sweentj/SproutSenseProto/SproutSync-Pin-Mapping-Petal-Ecosystem.xlsx

Sheet: Apollo3 Pin Functions
 |  |  |  |  |  |  |  |  |  | Pad Function Select Number (PADnFNCSEL) |  |  |  |  |  |  |  |  |  | NCE Chp Select Mux |  |  |  | CT CTimer Input Selection |  | CT - CTimer Output Selection
NM180100 Pin | Apollo3 BGA PIN | Apollo3 Pad | Design Notes | Schematic Net Name | Apollo3 Function Used | NCE/CT FNC Used | Pad FNCSEL # | NCE/CT Sel # | Pad | 0 | 1 | 2 | 3 | 4 | 5 | 6 | 7 | CSP PKG | Max Drive Strength | 0 | 1 | 2 | 3 | 0 | 1 | 2 | 3 | 4 | 5 | 6 | 7
C4 | H4 | PAD00 |  |  | GPIO00 |  | 3 |  | 0 | SLSCL | SLSCK | CLKOUT | GPIO00 | - | MSPI4 | - | NCE0 | X | 12mA | M3.2 | M4.2 | M5.2 | M1.3 |  |  |  |  |  |  |  |  | Function Highlight Control
C5 | G4 | PAD01 |  | WRT_ENA | GPIO01 |  | 3 | 2 | 1 | SLSDAWIR3 | SLMOSI | UART0TX | GPIO01 | - | MSPI5 | - | NCE1 | X | 12mA | M0.2 | M1.2 | M2.2 | MSPI.0 |  |  |  |  |  |  |  |  | Color Legend |  | Show ( Y/N)
C6 | F4 | PAD02 |  | IRRI_PHS | UART1RX |  | 0 | 3 | 2 | UART1RX | SLMISO | UART0RX | GPIO02 | - | MSPI6 | - | NCE2 | X | 12mA | M3.3 | M4.3 | M5.3 | M2.1 |  |  |  |  |  |  |  |  | IOS | IO Slave | y
D7 | G5 | PAD03 |  | RESERVE_GPIO* | GPIO03* |  | 3 |  | 3 | UA0RTS | SLnCE | NCE3 | GPIO03* | - | MSPI7 | TRIG1 | I2S _WCLK | X | 12mA | M3.0 | M4.0 | M5.0 | M2.0 |  |  |  |  |  |  |  |  | IOM0 | IO Master 0 | y
J6 | D9 | PAD04 |  | IRRI_ENA | GPIO04 |  | 3 |  | 4 | UA0CTS | SLINT | NCE4 | GPIO04 | - | UART1RX | CT17 | MSPI2 | X | 12mA | M3.1 | M4.1 | M5.1 | M1.1 |  | A4 | A4OUT2 | B7OUT | A4OUT | A1OUT2 | A6OUT2 | A7OUT2 | IOM1 | IO Master 1 | y
J5 | E9 | PAD05 |  | FLOW_PPS | GPIO05 |  | 3 |  | 5 | M0SCL | M0SCK | UA0RTS | GPIO05 | - | EXTHFA | - | CT8 | X | 12mA | - | - | - | - | A2 |  | A2OUT | A3OUT2 | A4OUT2 | B6OUT | A6OUT2 | A7OUT2 | IOM2 | IO Master 2 | y
G1 | E8 | PAD06 |  | FlOW_SNS_ENA | GPIO06 |  | 3 |  | 6 | M0SDAWIR3 | M0MISO | UA0CTS | GPIO06 | - | CT10 | - | I2S _DAT | X | 12mA | - | - | - | - | B2 |  | B2OUT | B3OUT2 | B4OUT2 | A6OUT | A6OUT2 | A7OUT2 | IOM3 | IO Master 3 | y
J4 | F9 | PAD07 |  | AMB_SNS_ENA | GPIO07 |  | 3 |  | 7 | NCE7 | M0MOSI | CLKOUT | GPIO07 | TRIG0 | UART0TX | - | CT19 | X | 12mA | M3.1 | M4.1 | M5.1 | MSPI.0 |  | B4 | B4OUT2 | A2OUT | B4OUT | B1OUT2 | A6OUT2 | A7OUT2 | IOM4 | IO Master 4 | y
F1 | F8 | PAD08 |  | PWR_ENA_5p0 | GPIO08 |  | 3 |  | 8 | M1SCL | M1SCK | NCE8 | GPIO08 | SCCCLK | - | UART1TX | - | X | 12mA | M3.0 | M4.0 | M5.0 | M0.0 |  |  |  |  |  |  |  |  | IOM5 | IO Master 5 | y
E2 | G7 | PAD09 |  |  | M1SDAWIR |  | 0 |  | 9 | M1SDAWIR | M1MISO | NCE9 | GPIO09 | SCCIO | - | UART1RX | - | X | 12mA | M3.3 | M4.3 | M5.3 | M2.3 |  |  |  |  |  |  |  |  | MSPI |  | y
E1 | G8 | PAD10 |  | nLORA_EN | GPIO10 |  | 3 |  | 10 | UART1TX | M1MOSI | NCE10 | GPIO10 | PDM_CLK | UA1RTS | - | - | X | 12mA | M3.2 | M4.2 | M5.2 | MSPI.0 |  |  |  |  |  |  |  |  | NCEx | SPI Master Chip Selects for IOM | y
B9 | B5 | PAD11 |  |  | NCE11 | M2.0 | 1 | 2 | 11 | ADCSE2 | NCE11 | CT31 | GPIO11 | SLINT | UA1CTS | UART0RX | PDM_DATA | X | 12mA | M0.0 | M1.0 | M2.0 | M3.0 |  | B7 | B7OUT2 | A6OUT | B7OUT | B3OUT2 | A6OUT2 | A7OUT2 | SCC |  | y
G9 | A7 | PAD12 |  |  | GPIO12 |  | 3 | 2 | 12 | ADCD0NSE9 | NCE12 | CT0 | GPIO12 | SLnCE | PDM_CLK | UA0CTS | UART1TX | X | 12mA | M3.0 | M4.0 | M5.0 | MSPI.1 | A0 |  | A0OUT | B2OUT2 | A5OUT2 | A6OUT | A6OUT2 | A7OUT2 | UART0 | UART0 | y
G8 | B7 | PAD13 |  |  | GPIO13 |  | 3 | 2 | 13 | ADCD0PSE8 | NCE13 | CT2 | GPIO13 | I2S_BCLK | EXTHFB | UA0RTS | UART1RX | X | 12mA | M3.1 | M4.1 | M5.1 | M0.1 | B0 |  | B0OUT | B1OUT2 | B6OUT2 | A7OUT | A6OUT2 | A7OUT2 | UART1 | UART1 | y
C3 | D7 | PAD14 |  | UART_TX | GPIO14 |  | 3 |  | 14 | ADCD1P | NCE14 | UART1TX | GPIO14 | PDM_CLK | EXTHFS | SWDCK | 32KHz_XT | X | 12mA | M0.2 | M1.2 | M2.2 | M4.2 |  |  |  |  |  |  |  |  | Analog | Analog Modules (ADC, VCOMP) | y
G7 | C7 | PAD15 |  | UART_RX | GPIO15 |  | 3 |  | 15 | ADCD1N | NCE15 | UART1RX | GPIO15 | PDM_DATA | EXTXT | SWDIO | SWO | X | 12mA | M0.3 | M1.3 | M2.3 | MSPI.0 |  |  |  |  |  |  |  |  | CT | Counter/Timers | y
C8 | D4 | PAD16 |  | USER_BUTTON | GPIO16 |  | 3 |  | 16 | ADCSE0 | NCE16 | TRIG0 | GPIO16 | SCCRST | CMPIN0 | UART0TX | UA1RTS | X | 12mA | M0.0 | M1.0 | M2.0 | M5.0 |  |  |  |  |  |  |  |  | CLKOUT | Clock output | y
B8 | D3 | PAD17 |  |  | UART0RX |  | 6 |  | 17 | CMPRF1 | NCE17 | TRIG1 | GPIO17 | SCCCLK | - | UART0RX | UA1CTS | X | 12mA | M0.1 | M1.1 | M2.1 | M4.1 |  |  |  |  |  |  |  |  | PWR Switch | GPIO (* = Power Switch included) | y
A9 | C5 | PAD18 |  |  | GPIO18 |  | 3 |  | 18 | CMPIN1 | NCE18 | CT4 | GPIO18 | UA0RTS | ANATEST2 | UART1TX | SCCIO | X | 12mA | M0.2 | M1.2 | M2.2 | M3.2 | A1 |  | A1OUT | A2OUT2 | A5OUT2 | B5OUT | A6OUT2 | A7OUT2 | Audio | Audio | y
D8 | C3 | PAD19 |  |  | NCE19 | MSPI.0 | 1 | 3 | 19 | CMPRF0 | NCE19 | CT6 | GPIO19 | SCCCLK | ANATEST1 | UART1RX | I2S_BCLK | X | 12mA | M0.3 | M1.3 | M3.3 | MSPI.0 | B1 |  | B1OUT | A1OUT | B5OUT2 | B7OUT | A6OUT2 | A7OUT2 | Debug | Debug | y
C2 | G6 | PAD20 |  | SWCLK | SWDCK |  | 0 |  | 20 | SWDCK | NCE20 | - | GPIO20 | UART0TX | UART1TX | I2S_BCLK | UA1RTS | X | 4mA | M3.1 | M4.1 | M5.1 | M2.1 |  |  |  |  |  |  |  |  | LOOPBACK | Reserved / Test | n
G5 | F7 | PAD21 |  | SWDIO | SWDIO |  | 0 |  | 21 | SWDIO | NCE21 | - | GPIO21 | UART0RX | UART1RX | SCCRST | UA1CTS | X | 12mA | M3.2 | M4.2 | M5.2 | M2.2 |  |  |  |  |  |  |  |  | X | CSP/BGA Y=Show all N = CSP Only | y
J7 | C9 | PAD22 |  |  | UART0TX |  | 0 |  | 22 | UART0TX | NCE22 | CT12 | GPIO22 | PDM_CLK | EXTLF | MSPI0 | SWO | X | 12mA | M3.3 | M4.3 | M5.3 | M0.3 | A3 |  | A3OUT | B1OUT | B0OUT2 | B6OUT2 | A6OUT2 | A7OUT2
D3 | D8 | PAD23 |  |  | UART0RX |  | 0 |  | 23 | UART0RX | NCE23 | CT14 | GPIO23 | I2S _WCLK | CMPOUT | MSPI3 | - | X | 12mA | M0.0 | M1.0 | M2.0 | M4.0 | B3 |  | B3OUT | B1OUT | B7OUT2 | A7OUT | A6OUT2 | A7OUT2 | Bold | Highlight Selected | y
E3 | C8 | PAD24 |  |  | GPIO24 |  | 3 |  | 24 | UART1TX | NCE24 | MSPI8 | GPIO24 | UA0CTS | CT21 | 32KHz_XT | SWO | X | 12mA | M0.1 | M1.1 | M2.1 | M5.1 |  | A5 | A5OUT2 | A1OUT | B5OUT | A0OUT2 | A6OUT2 | A7OUT2 | Grey | Shade unselected | y
G3 | A8 | PAD25 |  |  | M2MISO |  | 5 |  | 25 | UART1RX | NCE25 | CT1 | GPIO25 | M2SDAWIR3 | M2MISO | - | - | X | 12mA | M3.2 | M4.2 | M5.2 | M0.2 |  | A0 | A0OUT2 | A0OUT | A5OUT | B7OUT2 | A6OUT2 | A7OUT2
F3 | B8 | PAD26 |  |  | GPIO26 |  | 3 |  | 26 | EXTLF | NCE26 | CT3 | GPIO26 | SCCRST | MSPI1 | UART0TX | UA1CTS | X | 12mA | M3.3 | M4.3 | M5.3 | M1.3 |  | B0 | B0OUT2 | B0OUT | A1OUT | A6OUT | A6OUT2 | A7OUT2 | CT In/Out | Highlight Specific Ctimer In/Out | A0
J8 | B9 | PAD27 |  |  | M2SCK |  | 5 |  | 27 | UART0RX | NCE27 | CT5 | GPIO27 | M2SCL | M2SCK | - | - | X | 12mA | M3.0 | M4.0 | M5.0 | M1.0 |  | A1 | A1OUT2 | A1OUT | B6OUT | A7OUT | A6OUT2 | A7OUT2
H9 | A9 | PAD28 |  |  | M2MOSI |  | 5 |  | 28 | I2S _WCLK | NCE28 | CT7 | GPIO28 | - | M2MOSI | UART0TX | - | X | 12mA | M3.1 | M4.1 | M5.1 | MSPI.0 |  | B1 | B1OUT2 | B1OUT | B5OUT | A7OUT | A6OUT2 | A7OUT2 | * = High-Side power switch function 2-Ohm to VDD ** = Low-Side Power switch function 2-Ohm to Ground
C9 | A5 | PAD29 |  | SOIL_SNS_ENA | GPIO29 |  | 3 |  | 29 | ADCSE1 | NCE29 | CT9 | GPIO29 | UA0CTS | UA1CTS | UART0RX | PDM_DATA | X | 12mA | M3.2 | M4.2 | M5.2 | M1.2 |  | A2 | A2OUT2 | A2OUT | A4OUT | B0OUT | A6OUT2 | A7OUT2
D2 | F6 | PAD30 |  |  | UART0TX |  | 4 |  | 30 | - | NCE30 | CT11 | GPIO30 | UART0TX | UA1RTS | BLEIF_SCK | I2S _DAT |  | 12mA | M3.3 | M4.3 | M5.3 | M0.3 |  | B2 | B2OUT2 | B2OUT | B4OUT | B5OUT2 | A6OUT2 | A7OUT2
E7 | D5 | PAD31 |  |  | UART0RX |  | 4 | 0 | 31 | ADCSE3 | NCE31 | CT13 | GPIO31 | UART0RX | SCCCLK | BLEIF_MISO | UA1RTS |  | 12mA | M0.0 | M1.0 | M2.0 | M4.0 |  | A3 | A3OUT2 | A3OUT | A6OUT | B4OUT2 | A6OUT2 | A7OUT2 |  | Locked functions used by the macawBlue module
G6 | E6 | PAD32 |  | BAT_SNS_EN | GPIO32 |  | 3 |  | 32 | ADCSE4 | NCE32 | CT15 | GPIO32 | SCCIO | EXTLF | BLEIF_MOSI | UA1CTS |  | 12mA | M0.1 | M1.1 | M2.1 | MSPI.1 |  | B3 | B3OUT2 | B3OUT | A7OUT | A4OUT2 | A6OUT2 | A7OUT2
F8 | B6 | PAD33 |  | BAT_SNS_VAL | ADCSE5 |  | 0 |  | 33 | ADCSE5 | NCE33 | 32KHz_XT | GPIO33 | BLEIF_CSN | UA0CTS | CT23 | SWO |  | 12mA | M0.2 | M1.2 | M2.2 | M5.2 |  | B5 | B5OUT2 | A7OUT | A5OUT | B0OUT2 | A6OUT2 | A7OUT2
E8 | C6 | PAD34 |  | LED4, WIFI_UART_PETAL_RTS | UA0RTS |  | 5 |  | 34 | ADCSE6 | NCE34 | UA1RTS | GPIO34 | CMPRF2 | UA0RTS | UART0RX | PDM_DATA |  | 12mA | M0.3 | M1.3 | M2.3 | M3.3
F7 | D6 | PAD35 |  | USER_LED | GPIO35 |  | 3 |  | 35 | ADCSE7 | NCE35 | UART1TX | GPIO35 | I2S _DAT | CT27 | UA0RTS | BLEIF_STATUS |  | 12mA | M0.0 | M1.0 | M2.0 | M3.0 |  | B6 | B6OUT2 | A1OUT | B6OUT | B2OUT2 | A6OUT2 | A7OUT2
 | H6 | PAD36 |  | RADIO_NSS | NCE36 | M3.1 | 1 | 0 | 36 | TRIG1 | NCE36 | UART1RX | GPIO36* | 32KHz_XT | UA1CTS | UA0CTS | PDM_DATA |  | 12mA | M3.1 | M4.1 | M5.1 | MSPI.1
F2 | H7 | PAD37 |  | RESERVE_GPIO**, WIFI_RX_PETAL_TX1 | UART1TX |  | 5 |  | 37 | TRIG2 | NCE37 | UA0RTS | GPIO37** | SCCIO | UART1TX | PDM_CLK | CT29 |  | 12mA | M3.2 | M4.2 | M5.2 | M0.2 |  | A7 | B5OUT2 | A1OUT | A7OUT | A3OUT2 | A6OUT2 | A7OUT2
 | J6 | PAD38 |  | RADIO_MOSI | M3MOSI |  | 5 |  | 38 | TRIG3 | NCE38 | UA0CTS | GPIO38 | - | M3MOSI | UART1RX | - |  | 12mA | M0.3 | M1.3 | M2.3 | M5.3
 | J8 | PAD39 |  | RADIO_BUSY | GPIO39 |  | 3 |  | 39 | UART0TX | UART1TX | CT25 | GPIO39 | M4SCL | M4SCK | - | - | X | 12mA | - | - | - | - |  | A6 | B4OUT2 | B2OUT | A6OUT | A2OUT2 | A6OUT2 | A7OUT2
 | J9 | PAD40 |  | RADIO_DIO1 | GPIO40 |  | 3 |  | 40 | UART0RX | UART1RX | TRIG0 | GPIO40 | M4SDAWIR3 | M4MISO | - | - | X | 12mA | - | - | - | -
A8 | E5 | PAD41 |  | SWO | SWO |  | 2 |  | 41 | NCE41 | BLEIF_IRQ | SWO | GPIO41** | I2S _WCLK | UA1RTS | UART0TX | UA0RTS | X | 12mA | M0.1 | M1.1 | M2.1 | MSPI.1
 | H5 | PAD42 |  | RADIO_CLK | M3SCK |  | 5 |  | 42 | UART1TX | NCE42 | CT16 | GPIO42 | M3SCL | M3SCK | - | - |  | 12mA | M0.0 | M1.0 | M2.0 | M5.0 | A4 |  | A4OUT | A0OUT | A0OUT2 | B3OUT2 | A6OUT2 | A7OUT2
 | J5 | PAD43 |  | RADIO_MISO | M3MISO |  | 5 |  | 43 | UART1RX | NCE43 | CT18 | GPIO43 | M3SDAWIR3 | M3MISO | - | - |  | 12mA | M0.1 | M1.1 | M2.1 | MSPI.1 | B4 |  | B4OUT | B0OUT | A0OUT | A3OUT2 | A6OUT2 | A7OUT2
 | J7 | PAD44 |  | RADIO_nRESET | GPIO44 |  | 3 |  | 44 | UA1RTS | NCE44 | CT20 | GPIO44 | - | M4MOSI | UART0TX | - | X | 12mA | M0.2 | M1.2 | M2.2 | M5.2 | A5 |  | A5OUT | A1OUT | A1OUT2 | B2OUT2 | A6OUT2 | A7OUT2
C7 | F5 | PAD45 |  |  | GPIO45 |  | 3 |  | 45 | UA1CTS | NCE45 | CT22 | GPIO45 | I2S _DAT | PDM_DATA | UART0RX | SWO |  | 12mA | M3.3 | M4.3 | M5.3 | M1.3 | B5 |  | B5OUT | B1OUT | A6OUT | A2OUT2 | A6OUT2 | A7OUT2
G4 | E7 | PAD46 |  |  | GPIO46 |  | 3 |  | 46 | I2S_BCLK | NCE46 | CT24 | GPIO46 | SCCRST | PDM_CLK | UART1TX | SWO |  | 12mA | M3.0 | M4.0 | M5.0 | MSPI.1 | A6 |  | A6OUT | A2OUT | A1OUT | B1OUT2 | A6OUT2 | A7OUT2
 | H9 | PAD47 |  | RADIO_DIO3 | GPIO47 |  | 3 |  | 47 | 32KHz_XT | NCE47 | CT26 | GPIO47 | - | M5MOSI | UART1RX | - | X | 12mA | M0.1 | M1.1 | M2.1 | M3.1 | B6 |  | B6OUT | B2OUT | A5OUT | A1OUT2 | A6OUT2 | A7OUT2
J3 | G9 | PAD48 |  | I2C_SCL | M5SCL |  | 4 |  | 48 | UART0TX | NCE48 | CT28 | GPIO48 | M5SCL | M5SCK | - | - | X | 12mA | M0.2 | M1.2 | M2.2 | M3.2 | A7 |  | A7OUT | A3OUT | A5OUT2 | B0OUT2 | A6OUT2 | A7OUT2
G2 | H8 | PAD49 |  | I2C_SDA | M5SDAWIR3 |  | 4 |  | 49 | UART0RX | NCE49 | CT30 | GPIO49 | M5SDAWIR3 | M5MISO | - | - | X | 12mA | M0.3 | M1.3 | M2.3 | M4.3 | B7 |  | B7OUT | B3OUT | A4OUT2 | A0OUT2 | A6OUT2 | A7OUT2
 | A1 | SIMOBUCK_SW |  |  | SIMOBUCK_SW |  |  |  |  |  |  |  |  |  |  |  |  | X
 | A2 | SIMOBUCK_SWSEL |  |  | SIMOBUCK_SWSEL |  |  |  |  |  |  |  |  |  |  |  |  | X
 | A3 | VDDC |  |  | VDDC |  |  |  |  |  |  |  |  |  |  |  |  | X
F9 | A4 | XO |  |  | XO |  |  |  |  |  |  |  |  |  |  |  |  | X
 | A6 | X_ADCVREF |  |  | X_ADCVREF |  |  |  |  |  |  |  |  |  |  |  |  | X
 | B1 | VDDB |  |  | VDDB |  |  |  |  |  |  |  |  |  |  |  |  | X
 | B2 | VDDP |  |  | VDDP |  |  |  |  |  |  |  |  |  |  |  |  | X
 | B3 | VSSP |  |  | VSSP |  |  |  |  |  |  |  |  |  |  |  |  | X
E9 | B4 | XI |  |  | XI |  |  |  |  |  |  |  |  |  |  |  |  | X
 | C1 | VDDBH |  |  | VDDBH |  |  |  |  |  |  |  |  |  |  |  |  | X
 | C2 | VSSB |  |  | VSSB |  |  |  |  |  |  |  |  |  |  |  |  | X
 | C4 | VDDA |  |  | VDDA |  |  |  |  |  |  |  |  |  |  |  |  | X
 | D1 | VDDBH_SW |  |  | VDDBH_SW |  |  |  |  |  |  |  |  |  |  |  |  | X
 | D2 | VDDF |  |  | VDDF |  |  |  |  |  |  |  |  |  |  |  |  | X
 | E1 | VDDS |  |  | VDDS |  |  |  |  |  |  |  |  |  |  |  |  | X
 | E2 | VSS |  |  | VSS |  |  |  |  |  |  |  |  |  |  |  |  | X
 | E3 | VSSA |  |  | VSSA |  |  |  |  |  |  |  |  |  |  |  |  | X
 | E4 | X_NC |  |  | X_NC
 | F1 | XO32MP |  |  | XO32MP |  |  |  |  |  |  |  |  |  |  |  |  | X
 | F2 | VSSBA |  |  | VSSBA |  |  |  |  |  |  |  |  |  |  |  |  | X
 | F3 | VDDH |  |  | VDDH |  |  |  |  |  |  |  |  |  |  |  |  | X
 | G1 | XO32MM |  |  | XO32MM |  |  |  |  |  |  |  |  |  |  |  |  | X
 | G2 | VDCDCRF |  |  | VDCDCRF |  |  |  |  |  |  |  |  |  |  |  |  | X
 | G3 | RSTN |  | nRESET, C1 | RSTN |  |  |  |  |  |  |  |  |  |  |  |  | X
 | H1 | VSSVCO |  |  | VSSVCO |  |  |  |  |  |  |  |  |  |  |  |  | X
 | H2 | VSSS |  |  | VSSS |  |  |  |  |  |  |  |  |  |  |  |  | X
 | H3 | X_NC (DVDD) |  |  | X_NC (DVDD) |  |  |  |  |  |  |  |  |  |  |  |  | X
 | J1 | RFIOP |  |  | RFIOP |  |  |  |  |  |  |  |  |  |  |  |  | X
 | J2 | RFIOM |  |  | RFIOM |  |  |  |  |  |  |  |  |  |  |  |  | X
 | J3 | TXEN |  |  | TXEN
 | J4 | VCC |  |  | VCC |  |  |  |  |  |  |  |  |  |  |  |  | X
LEGEND |  | PETAL CORE
 |  | PETAL DEV BOARD
 |  | ENVIRONMENT PETAL
 |  | POWER PETAL
 |  | INTERNAL FUNCTION
 |  | SPARE/SPECIAL
 |  | WIFI PETAL

Sheet: Apollo3 Ball Map
Apollo3 BGA Ball Map | Apollo3 CSP Ball Map
