sweentj/SproutSenseProto/SprouSyncProto_01/SproutSyncProto_01.pdf

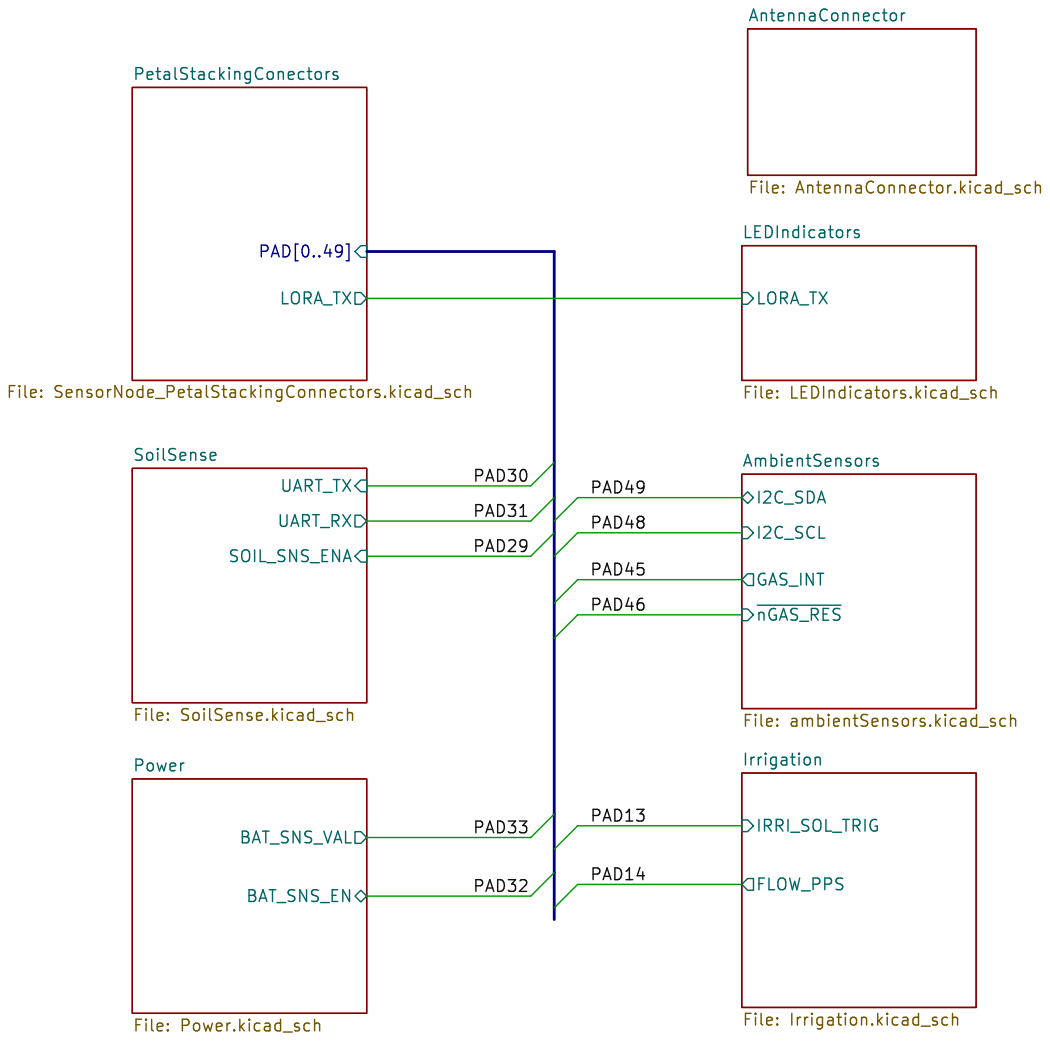
[picture p1: page 1]

LEDIndicators File: LEDIndicators.kicad_sch PAD[0..49] LORA_TX

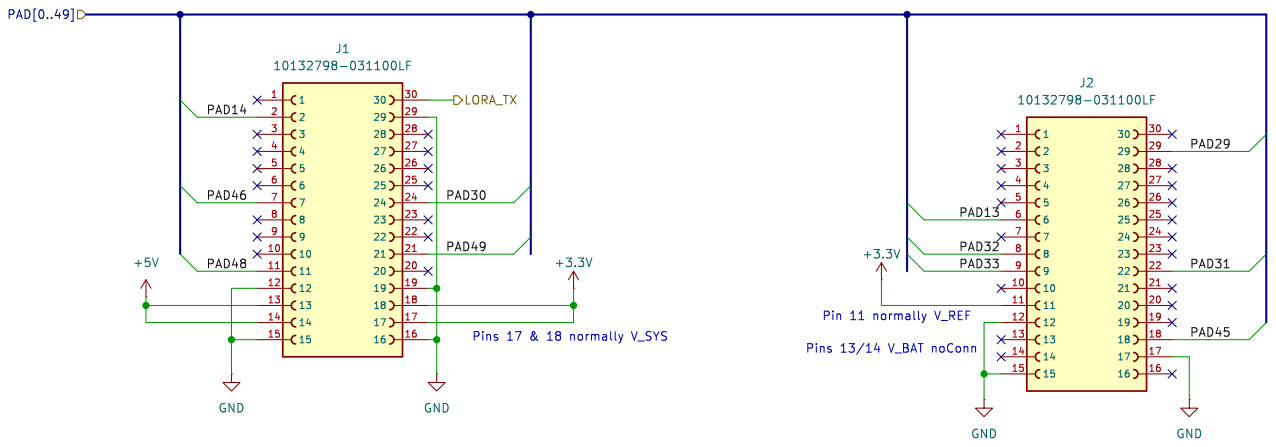
[picture p2: page 2]

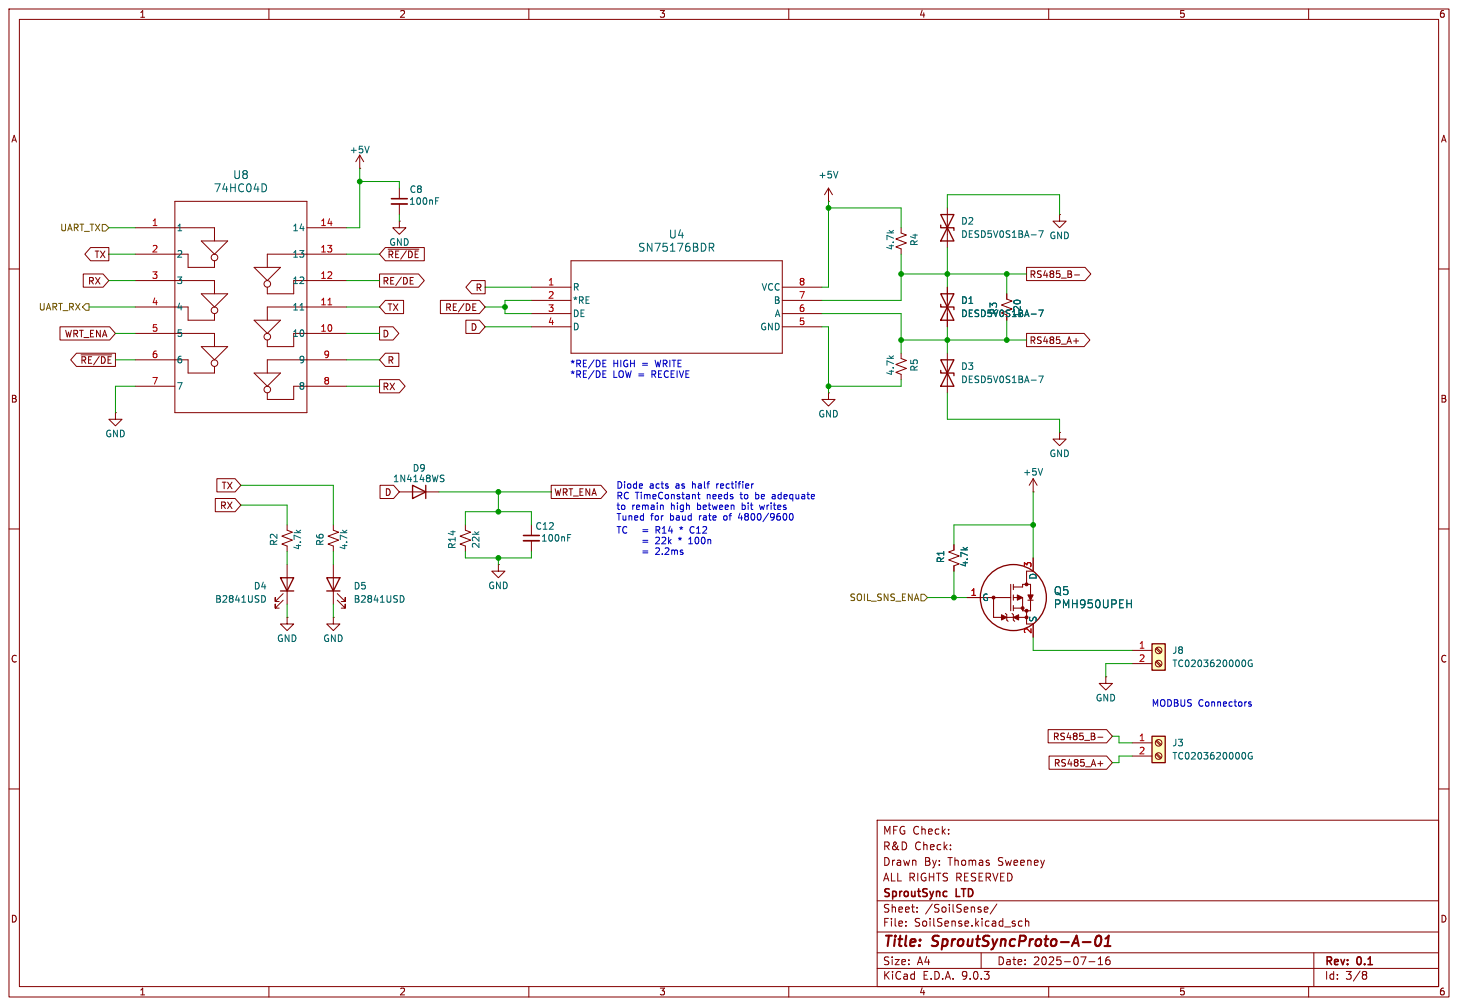
[picture p3: page 3]

*RE/DE HIGH = WRITE

to remain high between bit writes Tuned for baud rate of 4800/9600

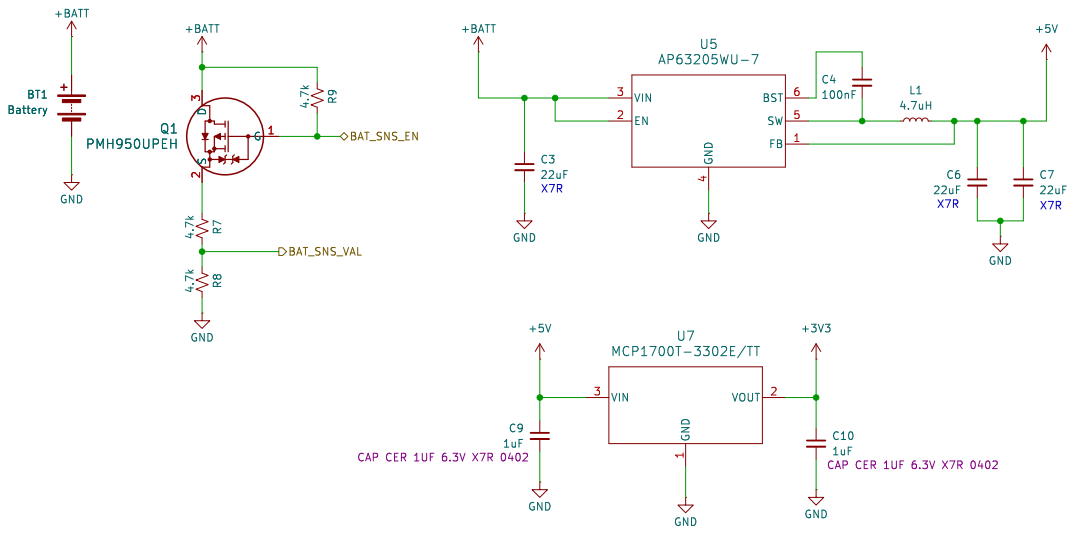
[picture p4: page 4]

4 BST 6 SW 5 FB 1 U5 AP63205WU-7 GND

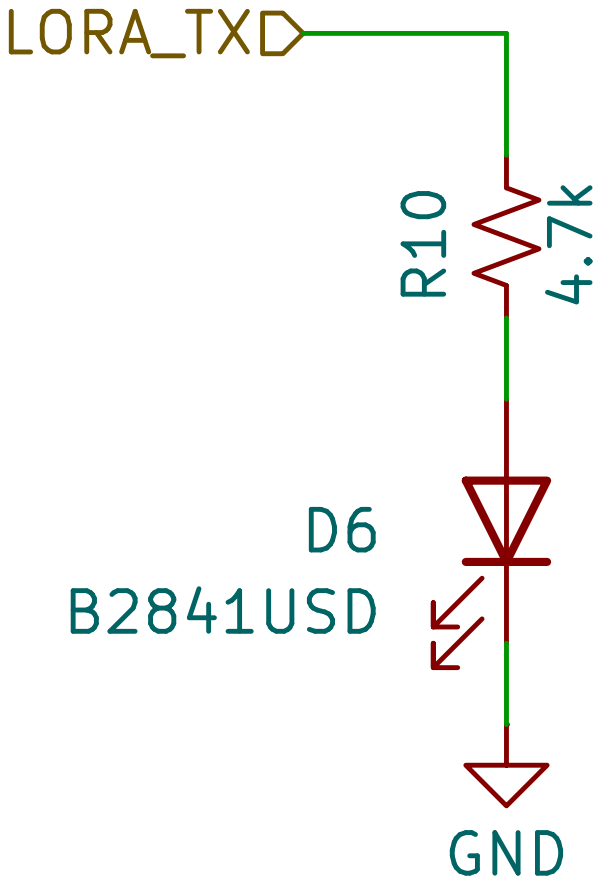
[picture p5: page 5]

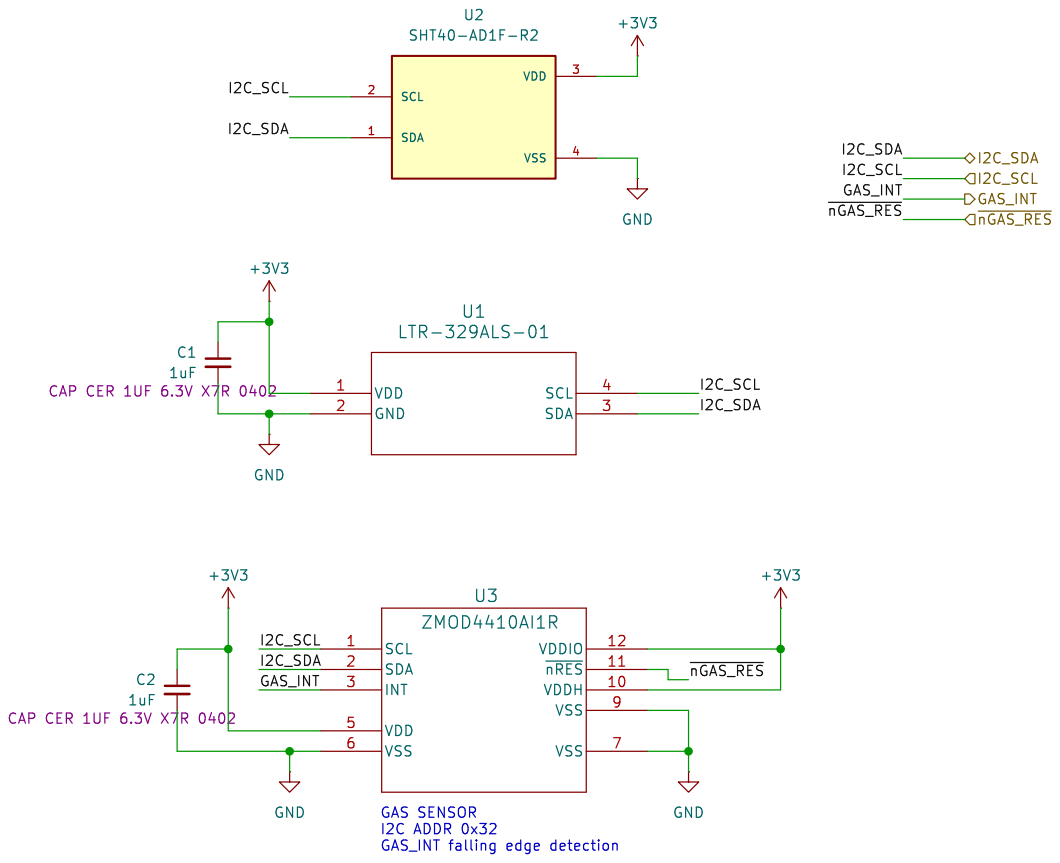
[picture p6: page 6]

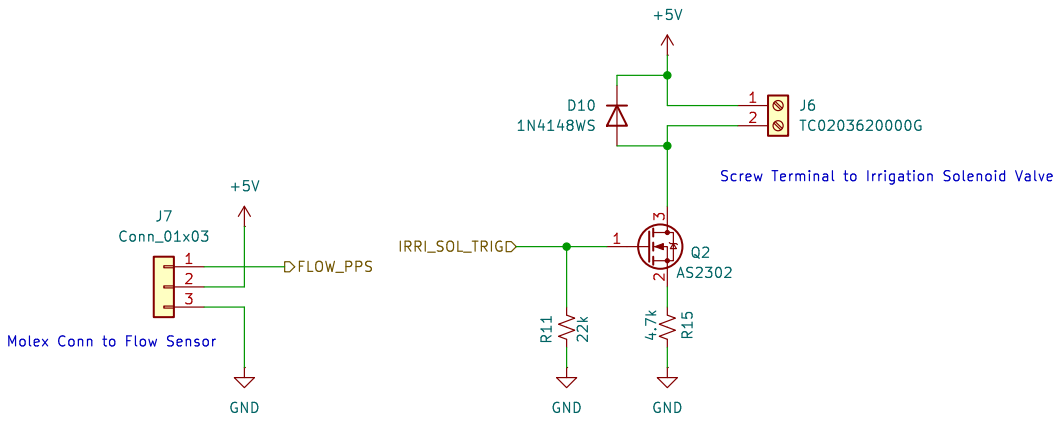
[picture p7: page 7]

File: Irrigation.kicad_sch Sheet: /Irrigation/
Id: 7/8 Title: SproutSyncProto-A-01

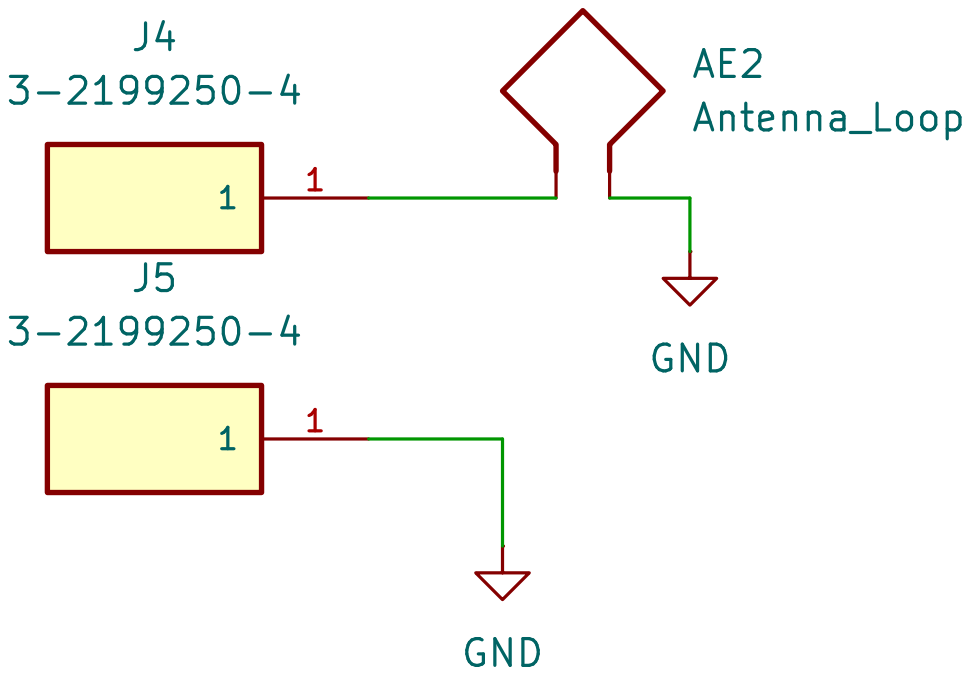
[picture p8: page 8]
