sweentj/SproutSenseProto/SproutSync_SensorNode.kicad_pcb

## KiCad design SproutSync_SensorNode.kicad_pcb (2026-09-30)

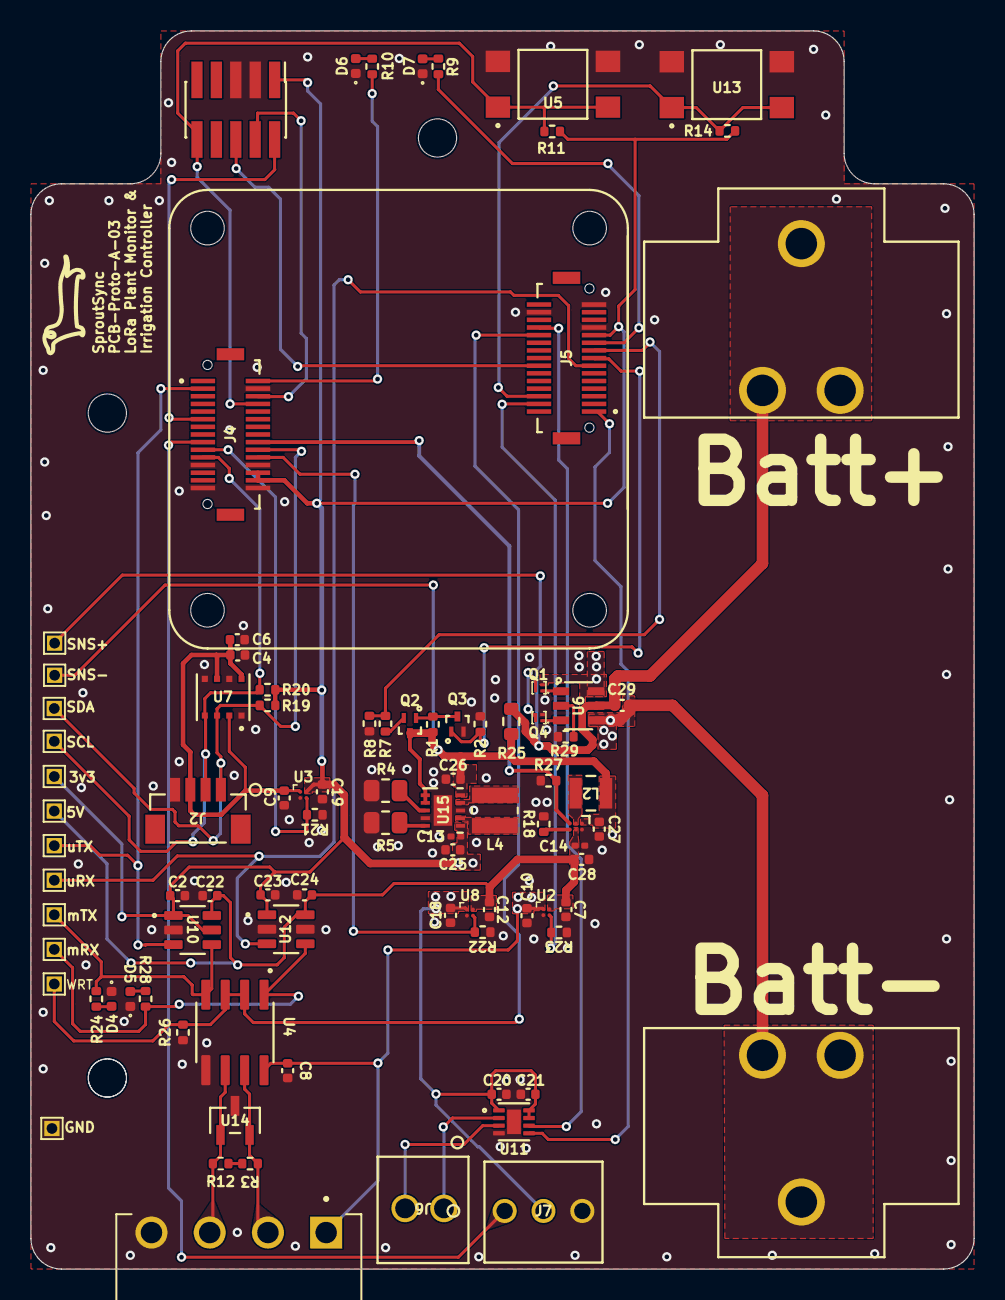
[picture p9: board SproutSync_SensorNode.kicad_pcb from above]

Board: 2 copper layers, 61.7 x 81.0 mm, 91 parts (0 on the bottom side), 53 nets.

Parts:
C2, C8, C9, C10, C18, C22, C23, C24, C29: 1uF; C_0402_1005Metric
C4, C6, C20, C21: 100nF; C_0402_1005Metric
C7, C12, C19, C25, C26, C27, C28: 22uF; C_0402_1005Metric
C13, C14: 10n; C_0201_0603Metric
D4, D5, D6, D7: B2841USD; LED_0402_1005Metric
J1: TBP02R1-381-04BE; CUI_TBP02R1-381-04BE
J2: BM04B-SRSS-TB; CONN4_BM04B-SRSS_JST
J3, J9: Conn_01x01_Socket; BAT_247
J4, J5: 10132797-031100LF; AMPHENOL_10132797-031100LF
J6: OSTVN02A150; CONN_OSTVN02A150_OST
J7: Conn_01x03; CONN_A-6373-03A_MOL
J8: Conn_ARM_JTAG_SWD_10; PinHeader_2x05_P1.27mm_Vertical_SMD
L2: DFE252012P-1R0M=P2
L4: 2.2u; IND_VLS3012CX-2R2M-1
Q1, Q4: CSD15380F3T; PICOSTAR-3_L0.7-W0.6-P0.35-TL
Q2: SSM3J35MFV; VESM_TOS
Q3: SSM3K16FV; VESM_TOS
R1, R2: 47k; R_0402_1005Metric
R3: 120; R_0402_1005Metric
R4: 36.5k; R_0805_2012Metric
R5: 16.2k; R_0805_2012Metric
R7: 20k; R_0402_1005Metric
R8: 18k; R_0402_1005Metric
R9, R10: 1k; R_0402_1005Metric
R11, R14, R19, R20, R21, R22, R23, R24, R27, R28: 4.7k; R_0402_1005Metric
R12: 0; R_0402_1005Metric
R18: 7.5k; R_0402_1005Metric
R25: 100m; R_0603_1608Metric
R26: 9.31k; R_0402_1005Metric
R29: 330; R_0402_1005Metric
TP1, TP2, TP5, TP6, TP7, TP8, TP9, TP10, TP11, TP12, TP14, TP15: TestPoint; TestPoint_THTPad_1.0x1.0mm_Drill0.5mm
U2, U3, U8: TPS22914BYFPR; YFP4_TEX
U4: SN65HVD3082EDR; SOIC127P599X175-8N
U5, U13: TL3305AF260QG; SW_TL3305AF260QG
U6: S-8240ADZ-M6T1U; SOT-23-6_L2.9-W1.6-P0.95-LS2.8-TL
U7: BME688; IC_BME688
U10, U12: SN74LVC1T45DBVR; SOT95P280X145-6N
U11: DRV8838DSGR; SON50P200X200X80-9N
U14: CDSOT23-SM712; SOT_SM712
U15: TPS63900DSKR; DSK0010A
U16: TPS61299YBHR; DSBGA6_YBH_TEX

Connections:
+3V3: C2.1, C13.1, C19.1, C23.1, C25.1, J4.17, J4.18, J5.11, J8.1 (VTref), R11.2, R14.2, R19.2, R20.2, TP14.1 (1_1), U3.A2 (VIN), U10.1 (VCCA), U10.5 (DIR), U12.1 (VCCA), U15.6 (VOUT)
+5V: C7.1, C12.1, C14.1, C22.1, C24.1, C28.1, TP15.1 (1_1), U2.A2 (VIN), U8.A2 (VIN), U10.6 (VCCB), U12.6 (VCCB), U16.B2 (VOUT)
+BATT: C26.1, C27.1, L2.1, Q2.3 (D), R1.2, R25.2, TP11.1 (1_1), U15.1 (EN), U15.2 (SEL), U15.10 (VIN), U16.A1 (VIN)
/DebugProbe/nRESET: J4.27, J8.10 (~RESET), R11.1, U5.1, U5.2
/PetalStackingConectors/LORA_TX: J4.30, R10.1
/PetalStackingConectors/PAD1: J5.20, R26.2, TP6.1 (1_1), U4.2 (~RE), U4.3 (DE)
/PetalStackingConectors/PAD2: J5.19, U11.6 (PH)
/PetalStackingConectors/PAD4: J5.1, U11.5 (EN)
/PetalStackingConectors/PAD5: J4.9, J7.1
/PetalStackingConectors/PAD6: J4.20, R22.2, U8.B2 (ON)
/PetalStackingConectors/PAD7: J4.10, R21.2, U3.B2 (ON)
/PetalStackingConectors/PAD8: J4.22, R27.2, U16.C1 (EN)
/PetalStackingConectors/PAD14: J4.2, TP2.1 (1_1), U10.3 (A)
/PetalStackingConectors/PAD15: J5.7, TP1.1 (1_1), U12.3 (A)
/PetalStackingConectors/PAD16: J5.28, R14.1, U13.1, U13.2
/PetalStackingConectors/PAD20: J4.28, J8.4 (SWCLK/TCK)
/PetalStackingConectors/PAD21: J4.6, J8.2 (SWDIO/TMS)
/PetalStackingConectors/PAD29: J5.29, R23.2, U2.B2 (ON)
/PetalStackingConectors/PAD32: J5.8, Q3.1 (G), R2.2
/PetalStackingConectors/PAD33: J5.9, R7.1, R8.2
/PetalStackingConectors/PAD35: J5.10, R9.1
/PetalStackingConectors/PAD41: J5.24, J8.6 (SWO/TDO)
/PetalStackingConectors/PAD48: J2.2, J4.11, R20.1, TP10.1 (1_1), U7.4 (SCK)
/PetalStackingConectors/PAD49: J2.1, J4.21, R19.1, TP9.1 (1_1), U7.3 (SDI)
AMB_PWR_3p3: C4.1, C6.1, C9.1, J2.3, U3.A1 (VOUT), U7.2 (CSB), U7.6 (VDDIO), U7.8 (VDD)
GND: C2.2, C4.2, C6.2, C7.2, C8.2, C9.2, C10.2, C12.2, C13.2, C14.2, C18.2, C19.2, C20.2, C21.2, C22.2, C23.2, C24.2, C25.2, C26.2, C27.2, C28.2, D4.1 (K), D5.1 (K), D6.1 (K), D7.1 (K), J1.4, J2.4, J4.12, J4.15, J4.16, J4.19, J4.29, J5.12, J5.15, J5.17, J7.3, J8.3 (GND), J8.5 (GND), Q3.2 (S), Q4.2 (S), R2.1, R4.2, R5.2, R8.1, R18.1, R21.1, R22.1, R23.1, R26.1, R27.1, R29.1, TP7.1 (1_1), U2.B1 (GND), U3.B1 (GND), U4.5 (GND), U5.3, U5.4, U7.1 (GND), U7.5 (SDO), U7.7 (GND__1), U8.B1 (GND), U10.2 (GND), U11.4 (GND), U11.9 (EXP), U12.2 (GND), U12.5 (DIR), U13.3, U13.4, U14.3 (common), U15.4 (CFG2), U15.8 (GND), U15.11 (TP), U16.A2 (GND)
GNDPWR: C29.2, J9.1 (Pin_1_1), Q1.2 (S), U6.4 (NC), U6.6 (VSS)
IRRI_PWR_5p0: C18.1, C20.1, C21.1, J7.2, U8.A1 (VOUT), U11.1 (VM), U11.7 (~SLEEP), U11.8 (VCC)
unnamed: D4.2 (A), R28.1
unnamed: D5.2 (A), R24.1
unnamed: D6.2 (A), R10.2
unnamed: D7.2 (A), R9.2
unnamed: C29.1, J3.1 (Pin_1_1), R25.1, TP8.1 (1_1), U6.5 (VDD)
unnamed: J6.1, U11.2 (OUT1)
unnamed: J6.2, U11.3 (OUT2)
unnamed: Q1.3 (D), Q4.3 (D)
unnamed: Q1.1 (G), U6.1 (DO)
unnamed: Q2.1 (G), Q3.3 (D), R1.1
unnamed: Q2.2 (S), R7.2
unnamed: Q4.1 (G), U6.3 (CO)
unnamed: R3.2, R12.1
unnamed: R29.2, U6.2 (VM)
unnamed: R4.1, U15.3 (CFG1)
unnamed: R5.1, U15.5 (CFG3)
unnamed: L4.1, U15.9 (L1)
unnamed: L4.2, U15.7 (L2)
unnamed: L2.2, U16.B1 (SW)
unnamed: R18.2, U16.C2 (VSEL)
RS485_A+: J1.3, R12.2, U4.6 (A), U14.1 (A1)
RS485_B-: J1.2, R3.1, U4.7 (B), U14.2 (A2)
RX: R28.2, TP12.1 (1_1), U4.1 (R), U12.4 (B)
SOIL_PWR_5p0: C8.1, C10.1, J1.1, U2.A1 (VOUT), U4.8 (VCC)
TX: R24.2, TP5.1 (1_1), U4.4 (D), U10.4 (B)
