sweentj/SproutSenseProto/(commit log)

2025-12-16 updated after bringup
    [Actuators.kicad_sch, AntennaConnector.kicad_sch, DebugProbe.kicad_sch, Irrigation.kicad_sch, Power.kicad_sch, SensorNode_PetalStackingConnectors.kicad_sch, SoilSense.kicad_sch, SproutSync-Pin-Mapping-Petal-Ecosystem.xlsx]
2025-12-16 replaced soil_sns frontend with SN74
    [DebugProbe.kicad_sch, SensorNode_PetalStackingConnectors.kicad_sch, SoilSense.kicad_sch, SproutSync-Pin-Mapping-Petal-Ecosystem.xlsx, SproutSync_SensorNode.kicad_sch]
2025-12-18 ver2 layout in progress
    [SensorNode_PetalStackingConnectors.kicad_sch, SoilSense.kicad_sch, SproutSync_SensorNode.kicad_pcb]
2025-12-20 rev2 precheck DRC clean
    [Power.kicad_sch, SoilSense.kicad_sch, SproutSync_SensorNode.kicad_pcb, ambientSensors.kicad_sch]
2026-01-02 add diode cathode indicator
    [SoilSense.kicad_sch, SproutSync_SensorNode.kicad_pcb]
2026-02-20 SWD port updated
    [SproutSync_SensorNode.kicad_pcb]
2026-04-30 updated schematic for pwr savings
    [DebugProbe.kicad_sch, Irrigation.kicad_sch, Power.kicad_sch, SensorNode_PetalStackingConnectors.kicad_sch, SoilSense.kicad_sch, SproutSync_SensorNode.kicad_pcb, SproutSync_SensorNode.kicad_sch, UserPeriphs.kicad_sch]
2026-05-04 updated pcb for pwr savings
    [DebugProbe.kicad_sch, Irrigation.kicad_sch, Power.kicad_sch, SensorNode_PetalStackingConnectors.kicad_sch, SoilSense.kicad_sch, SproutSync_SensorNode.kicad_pcb, SproutSync_SensorNode.kicad_sch, UserPeriphs.kicad_sch]
2026-05-05 increased size of BGA pad
    [SproutSync_SensorNode.kicad_pcb]
2026-05-05 updated BGA to 0.25mm
    [SproutSync_SensorNode.kicad_pcb]
2026-05-06 added vias
    [SproutSync_SensorNode.kicad_pcb]
2026-09-25 commit before redesign
    [Power.kicad_sch, SproutSync_SensorNode.kicad_pcb, SproutSync_SensorNode.kicad_sch]
2026-09-30 mutli soil sensor update
    [SoilSense.kicad_sch, SproutSync_SensorNode.kicad_pcb, SproutSync_SensorNode.kicad_sch, ambientSensors.kicad_sch]
