sweentj/SproutSenseProto/(notices)

Notices in the files:
Actuators.kicad_sch:
ALL RIGHTS RESERVED
